rishigovindnair-web/RishiMonitorArm/README.md

# Monitor arm for the Sceptre C32 (C325B-185RD1)

A 3D-printed desk-clamp arm for the Sceptre C32 240 Hz curved monitor. It screws into the four M4 inserts on the monitor's back and holds its 5.26 kg, with a bracket curved to sit flat on the 1800R housing. It adjusts height, swivel, reach, pan, tilt and rotation.

`step/monitor_arm_assembly.step` is the full arm, bolts included. `step/` and `stl/` hold each printed part.

## Parts

| Item | Store | Price |
|---|---|---|
| [JAYO PETG, 1.1 kg](https://www.amazon.com/dp/B0DCZ9ZLP9) | Amazon | $9.99 |
| [eono PETG, 1 kg](https://www.amazon.com/dp/B0G2BQQ5RT) | Amazon | $9.99 |
| [¾" × 18" black pipe](https://www.homedepot.com/p/VPC-3-4-in-x-1-5-ft-Black-Steel-Schedule-40-Cut-Pipe-21-707518/304751767) | Home Depot | $8.74 |
| [¼" × 2½" bolt](https://www.homedepot.com/p/Everbilt-1-4-in-20-x-2-1-2-in-Zinc-Plated-Hex-Bolt-800626/204633263) | Home Depot | $0.39 |
| [¼" nut](https://www.homedepot.com/p/Everbilt-1-4-in-20-Zinc-Plated-Hex-Nut-801736/204647886) | Home Depot | $0.14 |
| [M5 × 20 screws, 4-pack](https://www.homedepot.com/p/Everbilt-M5-0-8-x-20mm-Zinc-Pan-Head-Phillips-Drive-Machine-Screw-4-Pieces-836541/321071579) | Home Depot | $1.95 |
| [M6 × 25 screws, 4-pack](https://www.homedepot.com/p/Everbilt-M6-1-0-x-25mm-Zinc-Pan-Head-Phillips-Drive-Machine-Screw-4-Pieces-836721/321071584) | Home Depot | $1.95 |
| [⅜" × 1½" fender washer](https://www.homedepot.com/p/Everbilt-3-8-in-x-1-1-2-in-Zinc-Plated-Fender-Washer-804816/204632769) ×4 | Home Depot | $1.40 |
| [5/16" × 1½" fender washer](https://www.homedepot.com/p/Everbilt-5-16-in-x-1-1-2-in-Zinc-Plated-Fender-Washer-804806/204632770) ×2 | Home Depot | $0.58 |
| [M8 disc springs](https://www.aliexpress.us/item/3256806536117647.html) | AliExpress | $1.09 |
| [M4 × 12 screws](https://www.aliexpress.us/item/3256807033160325.html) | AliExpress | $1.42 |
| [M8 lock nuts](https://www.aliexpress.us/item/3256806985000344.html) | AliExpress | $2.92 |
| [M10 lock nuts](https://www.aliexpress.us/item/3256806985000344.html) | AliExpress | $4.25 |
| [M8 × 30 bolts](https://www.aliexpress.us/item/3256805904265069.html) | AliExpress | $2.81 |
| [M8 × 70 bolts](https://www.aliexpress.us/item/3256805904265069.html) | AliExpress | $4.05 |
| [M10 × 100 bolts](https://www.aliexpress.us/item/3256805904265069.html) | AliExpress | $3.92 |
| [M10 × 120 bolts](https://www.aliexpress.us/item/3256812494224390.html) | AliExpress | $4.82 |
| Subtotal |  | $60.41 |
| Shipping |  | $0.00 |
| Sales tax (9.75%) |  | $5.89 |
| Total |  | $66.30 |

You also need the stand's two M4 × 12 screws, an old bike inner tube for rubber, and a borrowed 6.5 mm drill bit.

## Printing

PETG, 0.2 mm layers, no supports, about 1.35 kg total. Desk clamp: 8 walls, 40% infill. Other parts: 4 to 6 walls, 15 to 20% infill. Print the three thin washers solid.

## Assembly

1. Press an M10 lock nut into the clamp's lower jaw, thread the M10 × 100 up through it, and glue on the knob and pad. Clamp it with the pole 45 mm in from the desk's back edge.
2. Push the pipe into the socket and lock it with an M6 screw.
3. Mark the pipe through the collar's side hole, drill a 6.5 mm hole through the pipe, and pin the collar with the ¼" bolt.
4. Slide link 1 onto the pipe. The second M6 screw sets how stiffly it swings.
5. Bolt link 2 on top of link 1, and the head under link 2. Each joint gets an M10 × 120, a printed washer between the parts and fender washers at both ends.
6. Bolt the bracket to the tilt block with the M8 × 30, add the M5 rotation lock, then screw the bracket to the monitor with four M4 × 12 screws.
7. Hang the tilt block in the yoke on the M8 × 70, stacked: washer, ear, rubber, tongue, rubber, ear, 3 disc springs (alternating), washer, lock nut. Tighten until it holds 5° forward.
8. Leave it at full reach for 24 hours, then retighten every nut.
