rishigovindnair-web/RishiMonitorArm/step/monitor_arm_assembly.step

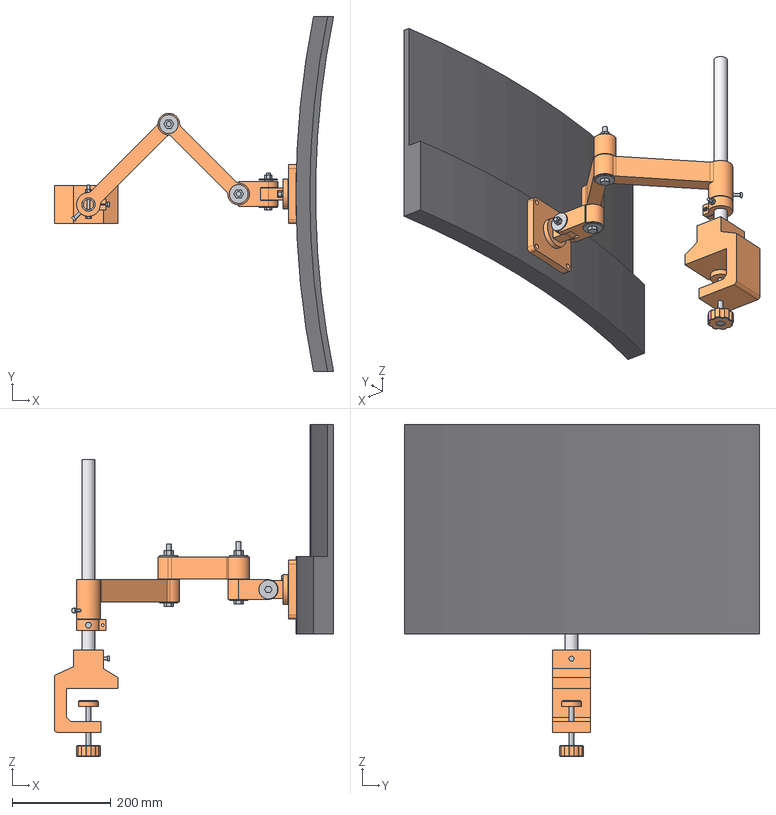
[picture p1: CAD file, 2026-10-18]
step/monitor_arm_assembly.step
565.3 x 719.0 x 672.0 mm
desk_clamp
clamp_pad
clamp_knob
pole
stop_collar
link1
link2
head_yoke
tilt_block
friction_washer_L
friction_washer_R
vesa_bracket
monitor
hw_clamp_bolt_M10x100
hw_pivot1_M10x120
hw_ptfe_washer_1
hw_pivot2_M10x120
hw_ptfe_washer_2
hw_tilt_bolt_M8x70
hw_rotation_bolt_M8x30
hw_nylon_washer_M8
hw_detent_M5x20
hw_monitor_screw_M4x12_BR
hw_monitor_screw_M4x12_TR
hw_monitor_screw_M4x12_BL
hw_monitor_screw_M4x12_TL
hw_pole_setscrew_M6x25
hw_swivel_setscrew_M6x25
hw_cross_pin_bolt_1-4x2-1-2
