rishigovindnair-web/RishiMonitorArm/step/link2.step

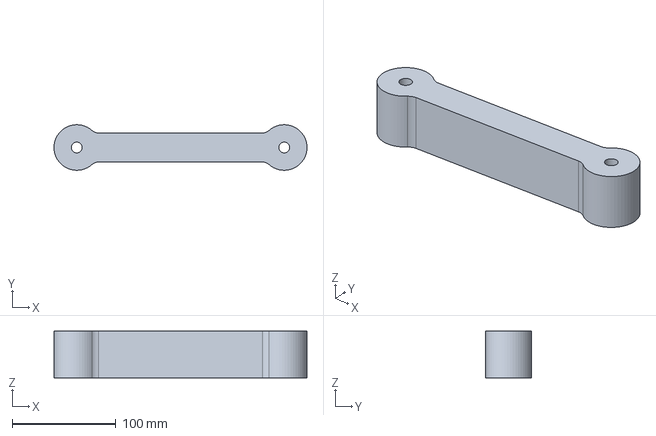
[picture p2: CAD file, 2026-10-18]
step/link2.step
243.9 x 44.0 x 45.0 mm
