rishigovindnair-web/RishiMonitorArm/step/clamp_knob.step

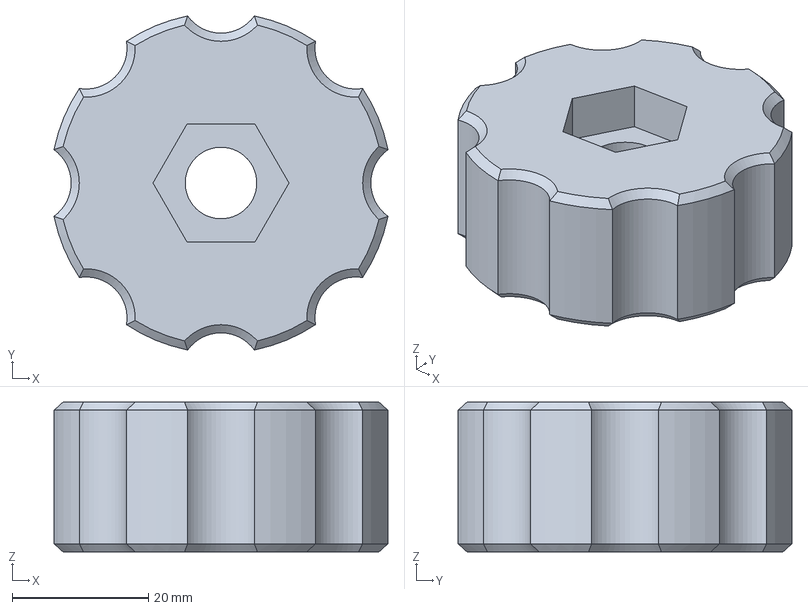
[picture p3: CAD file, 2026-10-18]
step/clamp_knob.step
49.0 x 49.0 x 22.0 mm
