rishigovindnair-web/RishiMonitorArm/step/link1.step

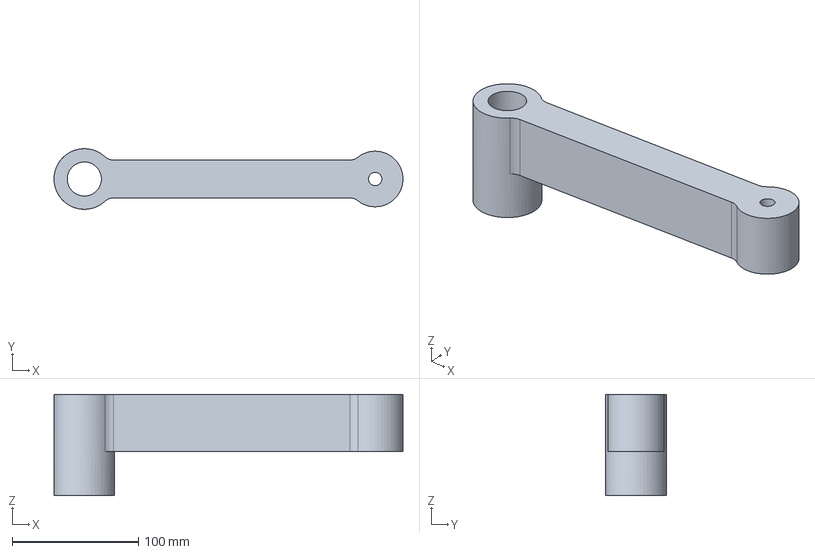
[picture p4: CAD file, 2026-10-18]
step/link1.step
276.0 x 48.0 x 80.0 mm
