rishigovindnair-web/RishiMonitorArm/step/clamp_pad.step

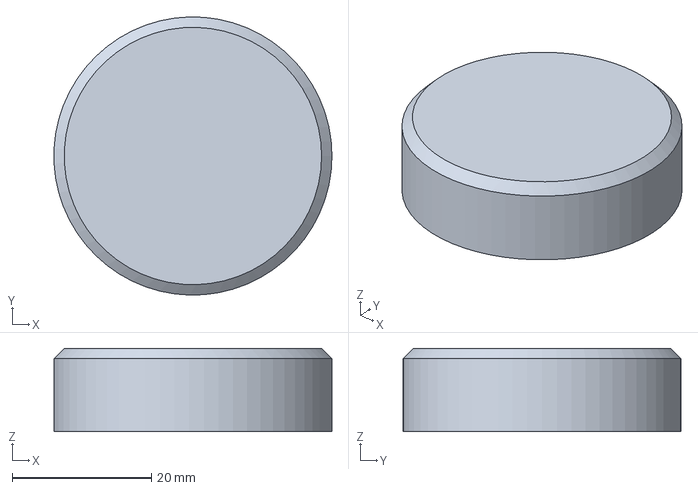
[picture p5: CAD file, 2026-10-18]
step/clamp_pad.step
40.0 x 40.0 x 12.0 mm
