rishigovindnair-web/RishiMonitorArm/step/desk_clamp.step

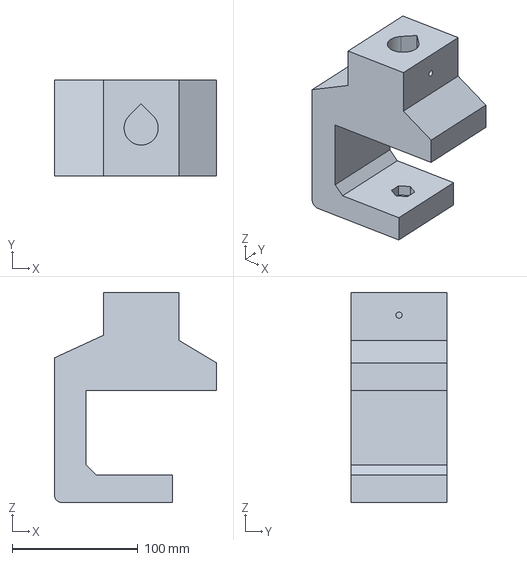
[picture p6: CAD file, 2026-10-18]
step/desk_clamp.step
129.0 x 76.0 x 167.0 mm
