rishigovindnair-web/RishiMonitorArm/step/head_yoke.step

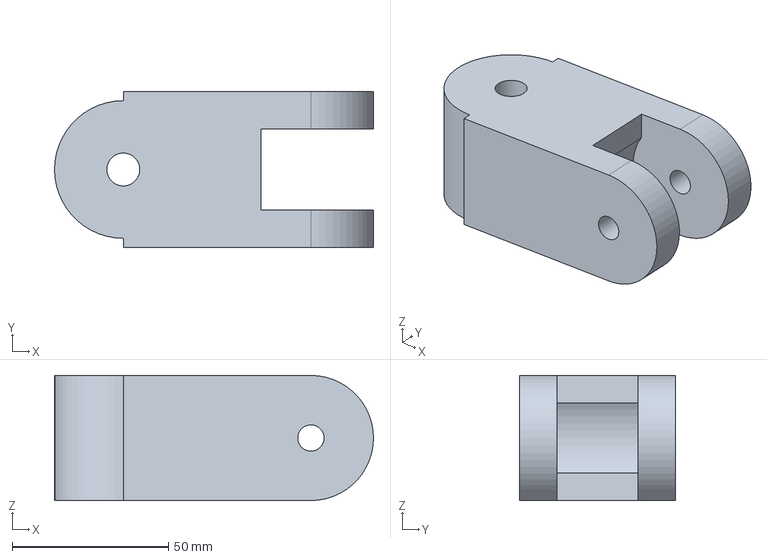
[picture p7: CAD file, 2026-10-18]
step/head_yoke.step
102.0 x 50.0 x 40.0 mm
