rishigovindnair-web/RishiMonitorArm/step/stop_collar.step

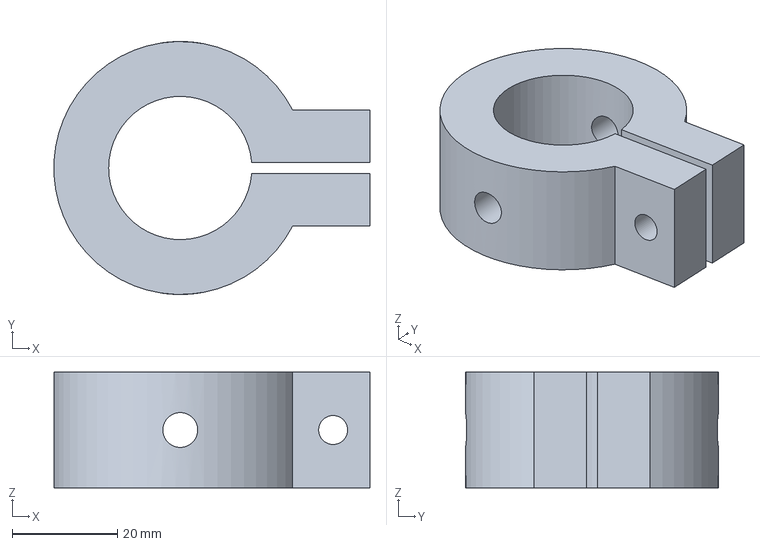
[picture p8: CAD file, 2026-10-18]
step/stop_collar.step
60.0 x 48.0 x 22.0 mm
