rishigovindnair-web/RishiMonitorArm/step/tilt_block.step

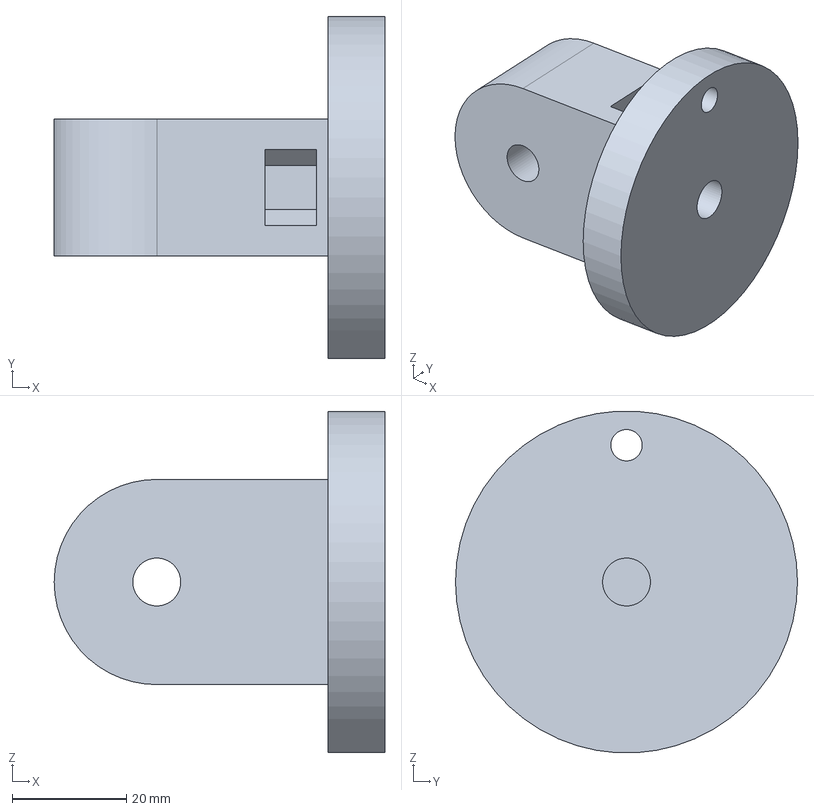
[picture p9: CAD file, 2026-10-18]
step/tilt_block.step
58.0 x 60.0 x 59.9 mm
