rishigovindnair-web/RishiMonitorArm/step/vesa_bracket.step

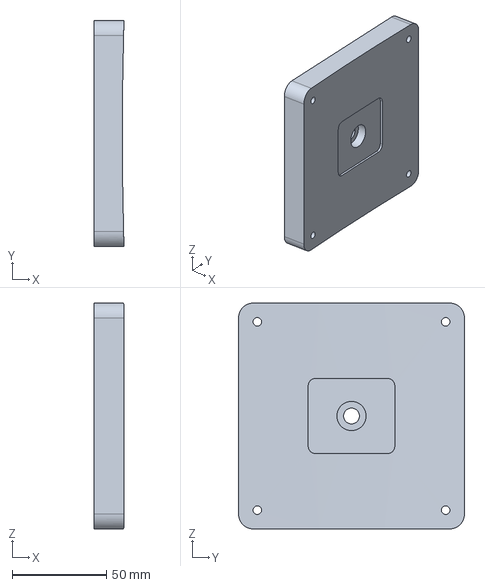
[picture p10: CAD file, 2026-10-18]
step/vesa_bracket.step
16.0 x 120.0 x 120.0 mm
