rishigovindnair-web/RishiMonitorArm/step/friction_washer.step

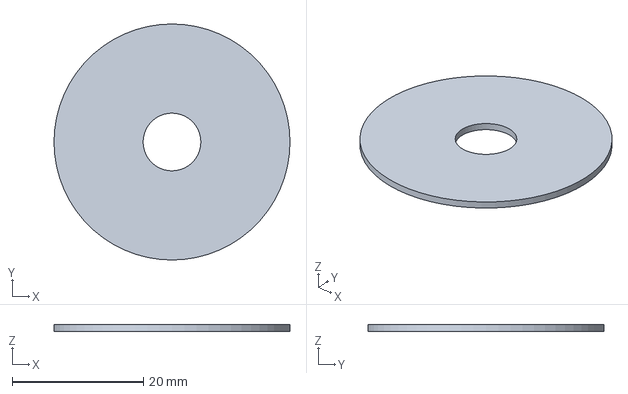
[picture p11: CAD file, 2026-10-18]
step/friction_washer.step
36.0 x 36.0 x 1.00 mm
