rishigovindnair-web/RishiMonitorArm/step/rotation_washer_M8.step

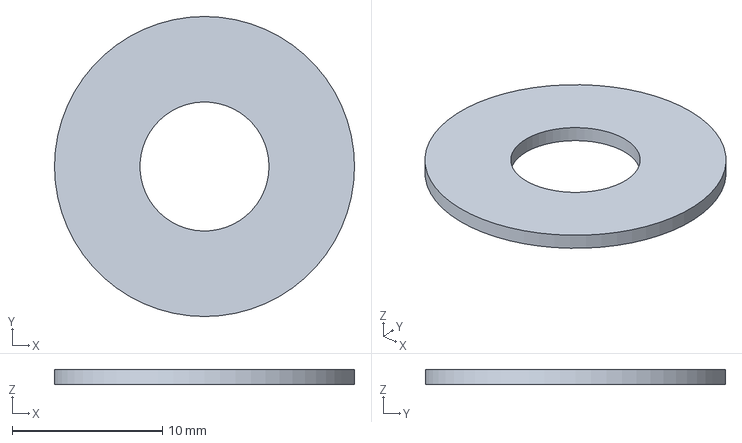
[picture p12: CAD file, 2026-10-18]
step/rotation_washer_M8.step
20.0 x 20.0 x 1.00 mm
