rishigovindnair-web/RishiMonitorArm/step/pivot_washer_M10.step

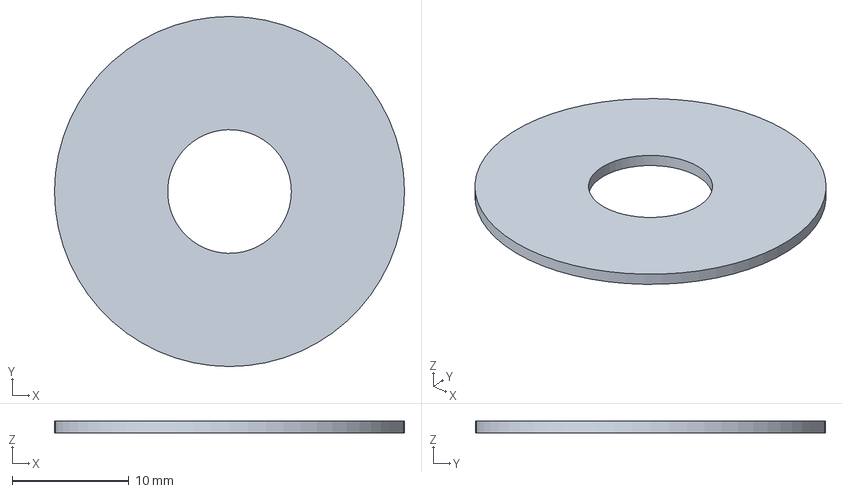
[picture p13: CAD file, 2026-10-18]
step/pivot_washer_M10.step
30.0 x 30.0 x 1.00 mm
