rishigovindnair-web/RishiMonitorArm/(list of files, cad)

Other CAD files:
stl/clamp_knob.stl
stl/clamp_pad.stl
stl/desk_clamp.stl
stl/friction_washer.stl
stl/head_yoke.stl
stl/link1.stl
stl/link2.stl
stl/pivot_washer_M10.stl
stl/rotation_washer_M8.stl
stl/stop_collar.stl
stl/tilt_block.stl
stl/vesa_bracket.stl
