rishigovindnair-web/RishiMonitorArm/(commit log)

2026-10-18 Add README with parts list, costs and assembly guide
2026-10-18 Add STEP files: full assembly and every printed part
    [clamp_knob.step, clamp_pad.step, desk_clamp.step, friction_washer.step, head_yoke.step, link1.step, link2.step, monitor_arm_assembly.step]
2026-10-18 Add print-ready STL files
    [clamp_knob.stl, clamp_pad.stl, desk_clamp.stl, friction_washer.stl, head_yoke.stl, link1.stl, link2.stl, pivot_washer_M10.stl]
